rktech-de/PowerMeter-D0/README.md

# PowerMeter-D0
Read PowerMeter D0 (IR) interface with ESP8266 and transmit as MQTT
