rktech-de/PowerMeter-D0/Arduino/README.md

# PowerMeter-D0
Code for Arduino IDE with ESP8266 (WIMO-D1) boards
