rktech-de/PowerMeter-D0/KiCad/Energiezähler-BOM.md

# Energiezähler.kicad_sch BOM

Mo 14 Nov 2022 20:32:45 CET

Generated from schematic by Eeschema 6.0.9-8da3e8f707~116~ubuntu20.04.1

**Component Count:** 31

| Refs | Qty | Component | Description |
| ----- | --- | ---- | --- |
| C101, C103, C106 | 3 | 100n | Unpolarized capacitor<br />Capacitor_SMD:C_0805_2012Metric_Pad1.18x1.45mm_HandSolder |
| C102, C104 | 2 | 100u | Polarized capacitor<br />Capacitor_THT:CP_Radial_D6.3mm_P2.50mm |
| C105 | 1 | 47p | Unpolarized capacitor<br />Capacitor_SMD:C_0805_2012Metric_Pad1.18x1.45mm_HandSolder |
| C107 | 1 | 47n | Unpolarized capacitor<br />Capacitor_SMD:C_0805_2012Metric_Pad1.18x1.45mm_HandSolder |
| D101 | 1 | LED red | Light emitting diode<br />LED_THT:LED_D3.0mm |
| D102 | 1 | LED yellow | Light emitting diode<br />LED_THT:LED_D3.0mm |
| J101 | 1 | Power | Generic connector, single row, 01x02, script generated (kicad-library-utils/schlib/autogen/connector/)<br />Connector_PinHeader_2.54mm:PinHeader_1x02_P2.54mm_Vertical |
| J102 | 1 | Sensor | Generic connector, single row, 01x04, script generated (kicad-library-utils/schlib/autogen/connector/)<br />Connector_PinHeader_2.54mm:PinHeader_1x04_P2.54mm_Vertical |
| Q0 | 1 | SFH309 | Phototransistor NPN<br />http://www.osram-os.com/Graphics/XPic2/00101811_0.pdf/SFH%20309,%20SFH%20309%20FA,%20Lead%20(Pb)%20Free%20Product%20-%20RoHS%20Compliant.pdf<br />LED_THT:LED_D3.0mm_Clear |
| R101, R108 | 2 | 100k | Resistor<br />Resistor_SMD:R_0805_2012Metric_Pad1.20x1.40mm_HandSolder |
| R102, R103 | 2 | 330R | Resistor<br />Resistor_SMD:R_0805_2012Metric_Pad1.20x1.40mm_HandSolder |
| R104, R106 | 2 | 12k | Resistor<br />Resistor_SMD:R_0805_2012Metric_Pad1.20x1.40mm_HandSolder |
| R105, R111, R112 | 3 | 10k | Resistor<br />Resistor_SMD:R_0805_2012Metric_Pad1.20x1.40mm_HandSolder |
| R107 | 1 | 220R | Resistor<br />Resistor_SMD:R_0805_2012Metric_Pad1.20x1.40mm_HandSolder |
| R109 | 1 | 47k | Resistor<br />Resistor_SMD:R_0805_2012Metric_Pad1.20x1.40mm_HandSolder |
| R110 | 1 | 22k | Resistor<br />Resistor_SMD:R_0805_2012Metric_Pad1.20x1.40mm_HandSolder |
| R113 | 1 | 120R | Resistor<br />Resistor_SMD:R_0805_2012Metric_Pad1.20x1.40mm_HandSolder |
| RV101 | 1 | Varistor | Voltage dependent resistor<br />Diode_THT:D_A-405_P12.70mm_Horizontal |
| RV102 | 1 | 10k | Trim-potentiometer<br />Potentiometer_THT:Potentiometer_Bourns_3266W_Vertical |
| SW101 | 1 | SW_Push | Push button switch, generic, two pins<br />Button_Switch_THT:SW_Tactile_SPST_Angled_PTS645Vx58-2LFS |
| U101 | 1 | DC/DC | Generic connector, single row, 01x04, script generated (kicad-library-utils/schlib/autogen/connector/)<br />https://www.amazon.de/PEMENOL-Einstellbar-Spannungwandler-Stromversorgung-Wirkungsgrad/dp/B07DP2MDJQ<br />Connector_PinHeader_2.54mm:PinHeader_1x04_P2.54mm_Vertical |
| U102 | 1 | LMV393 | http://www.ti.com/lit/ds/symlink/lmv331.pdf<br />Package_DIP:DIP-8_W7.62mm |
| U103 | 1 | WeMos_D1_mini | https://wiki.wemos.cc/products:d1:d1_mini#documentation<br />ESP8266:wemos-d1-mini-with-pin-header |
