rktech-de/PowerMeter-D0/KiCad/Montage-all.pdf

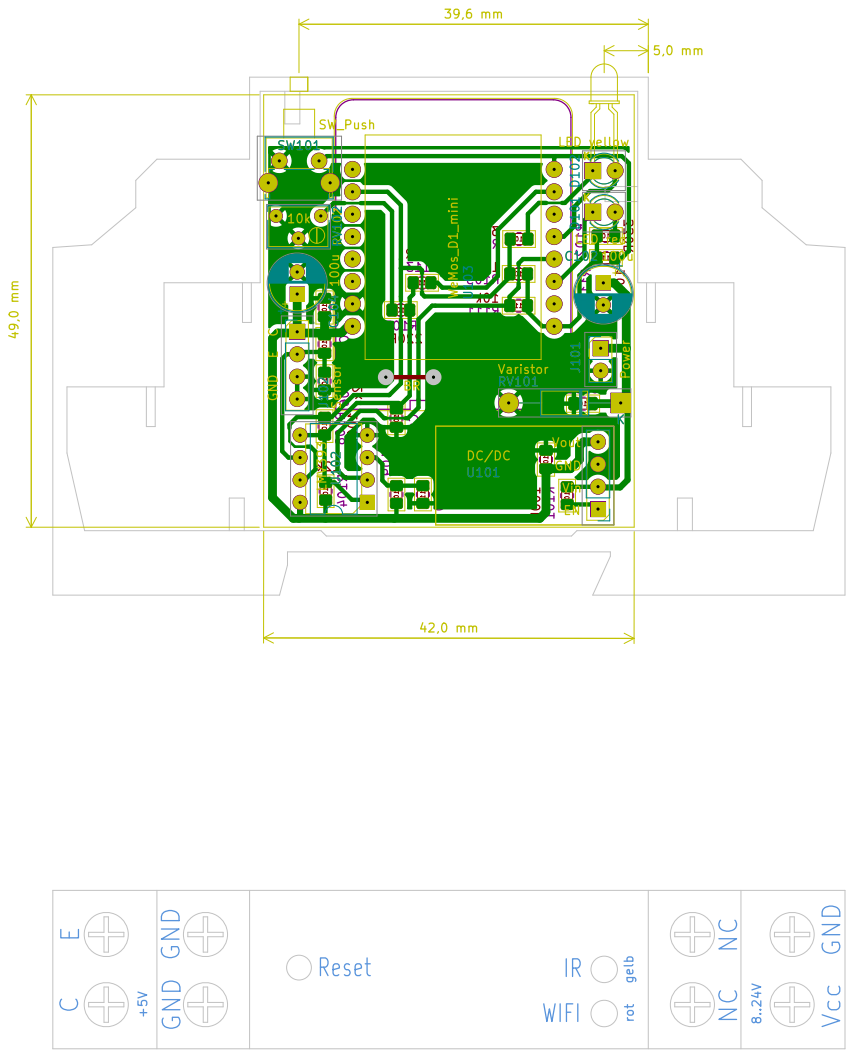
[picture p1: page 1]
