rktech-de/PowerMeter-D0/KiCad/Montage-B.pdf

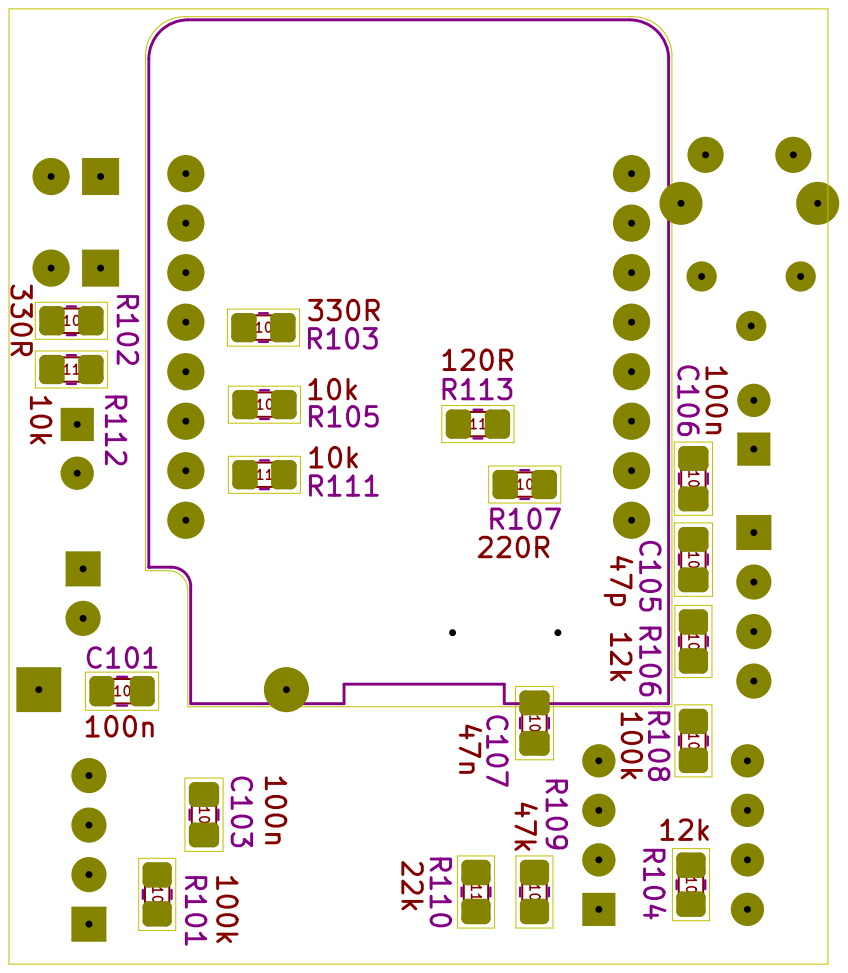
[picture p2: page 1]
