rktech-de/PowerMeter-D0/KiCad/Montage-F.pdf

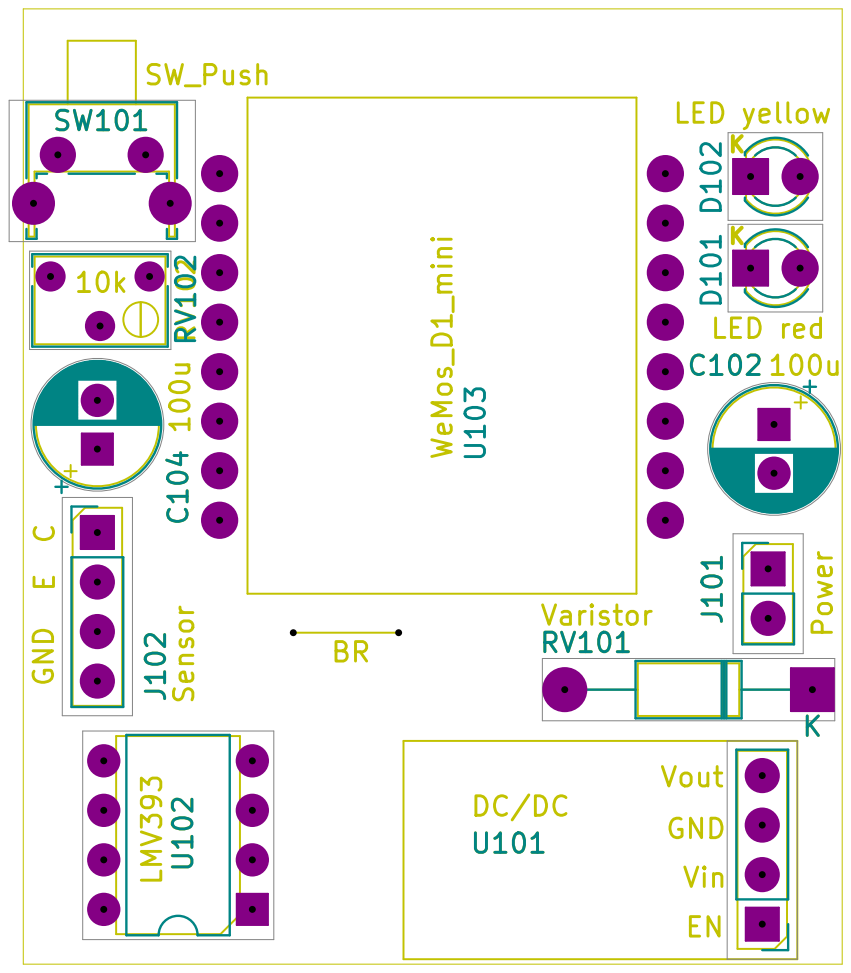
[picture p3: page 1]
