rktech-de/PowerMeter-D0/KiCad/Stromlauf.pdf

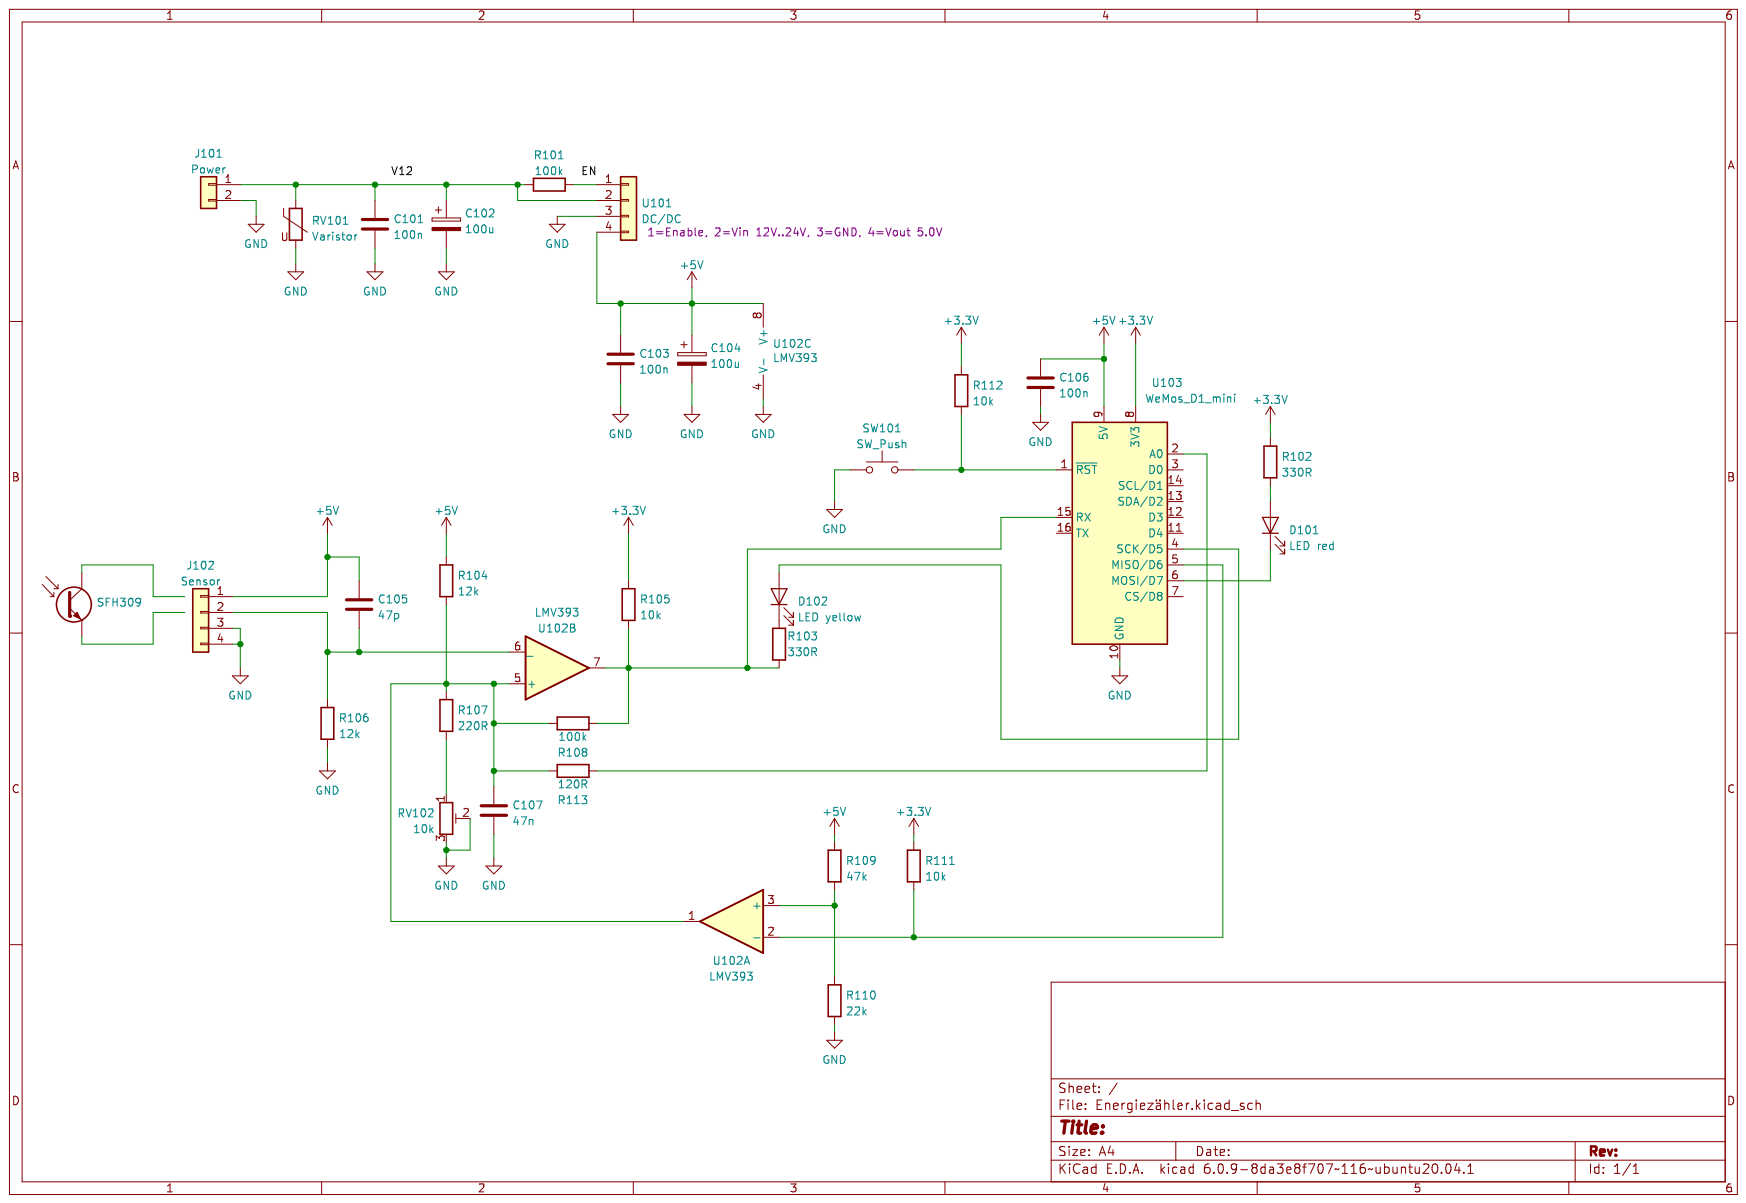
[picture p4: page 1]
