rktech-de/PowerMeter-D0/KiCad/Energiezähler.kicad_pcb

## KiCad design KiCad/Energiezähler.kicad_pcb (2022-11-14)

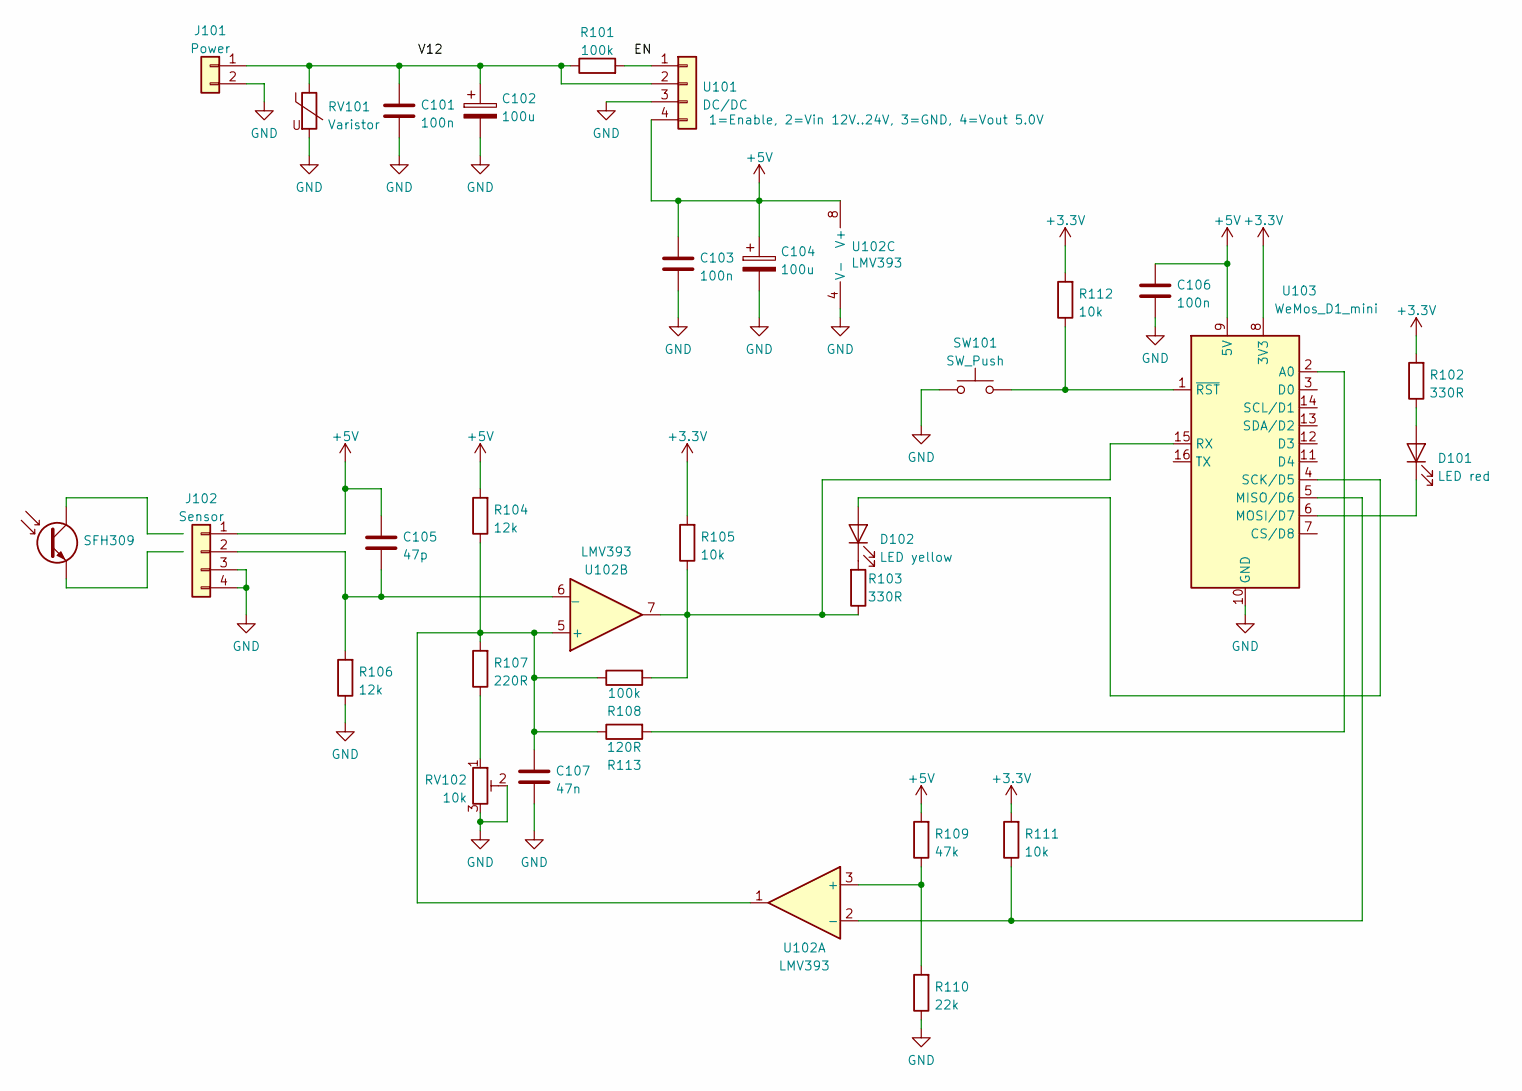
[picture p5: schematic Energiezähler.kicad_sch]

Parts:
C101, C103, C106: 100n; C_0805_2012Metric_Pad1.18x1.45mm_HandSolder
C102, C104: 100u; CP_Radial_D6.3mm_P2.50mm
C105: 47p; C_0805_2012Metric_Pad1.18x1.45mm_HandSolder
C107: 47n; C_0805_2012Metric_Pad1.18x1.45mm_HandSolder
D101: LED red; LED_D3.0mm
D102: LED yellow; LED_D3.0mm
J101: Power; PinHeader_1x02_P2.54mm_Vertical
J102: Sensor; PinHeader_1x04_P2.54mm_Vertical
Q0: SFH309
R101, R108: 100k; R_0805_2012Metric_Pad1.20x1.40mm_HandSolder
R102, R103: 330R; R_0805_2012Metric_Pad1.20x1.40mm_HandSolder
R104, R106: 12k; R_0805_2012Metric_Pad1.20x1.40mm_HandSolder
R105, R111, R112: 10k; R_0805_2012Metric_Pad1.20x1.40mm_HandSolder
R107: 220R; R_0805_2012Metric_Pad1.20x1.40mm_HandSolder
R109: 47k; R_0805_2012Metric_Pad1.20x1.40mm_HandSolder
R110: 22k; R_0805_2012Metric_Pad1.20x1.40mm_HandSolder
R113: 120R; R_0805_2012Metric_Pad1.20x1.40mm_HandSolder
RV101: Varistor; D_A-405_P12.70mm_Horizontal
RV102: 10k; Potentiometer_Bourns_3266W_Vertical
SW101: SW_Push; SW_Tactile_SPST_Angled_PTS645Vx58-2LFS
U101: DC/DC; PinHeader_1x04_P2.54mm_Vertical
U102: LMV393; DIP-8_W7.62mm
U103: WeMos_D1_mini; wemos-d1-mini-with-pin-header

Connections:
+3V3: R102.2, R105.2, R111.2, R112.2, U103.8 (3V3)
+5V: C103.1, C104.1, C105.1, C106.1, J102.1, R104.2, R109.2, U101.4, U102.8 (V+), U103.9 (5V)
GND: C101.2, C102.2, C103.2, C104.2, C106.2, C107.2, J101.2, J102.3, J102.4, R106.1, R110.1, RV101.2, RV102.2, RV102.3, SW101.1, U101.3, U102.4 (V-), U103.10 (GND)
unnamed: C101.1, C102.1, J101.1, R101.1, RV101.1, U101.2
unnamed: C105.2, J102.2, R106.2, U102.6 (_)
unnamed: C107.1, R104.1, R107.2, R108.1, R113.1, U102.1, U102.5 (+)
unnamed: D101.1 (K), U103.6 (MOSI/D7)
unnamed: D101.2 (A), R102.1
unnamed: D102.1 (K), R103.2
unnamed: D102.2 (A), U103.4 (SCK/D5)
unnamed: R101.2, U101.1
unnamed: R103.1, R105.1, R108.2, U102.7, U103.15 (RX)
unnamed: R107.1, RV102.1
unnamed: R109.1, R110.2, U102.3 (+)
unnamed: R111.1, U102.2 (-), U103.5 (MISO/D6)
unnamed: R112.1, SW101.2, U103.1 (~RST)
unnamed: R113.2, U103.2 (A0)

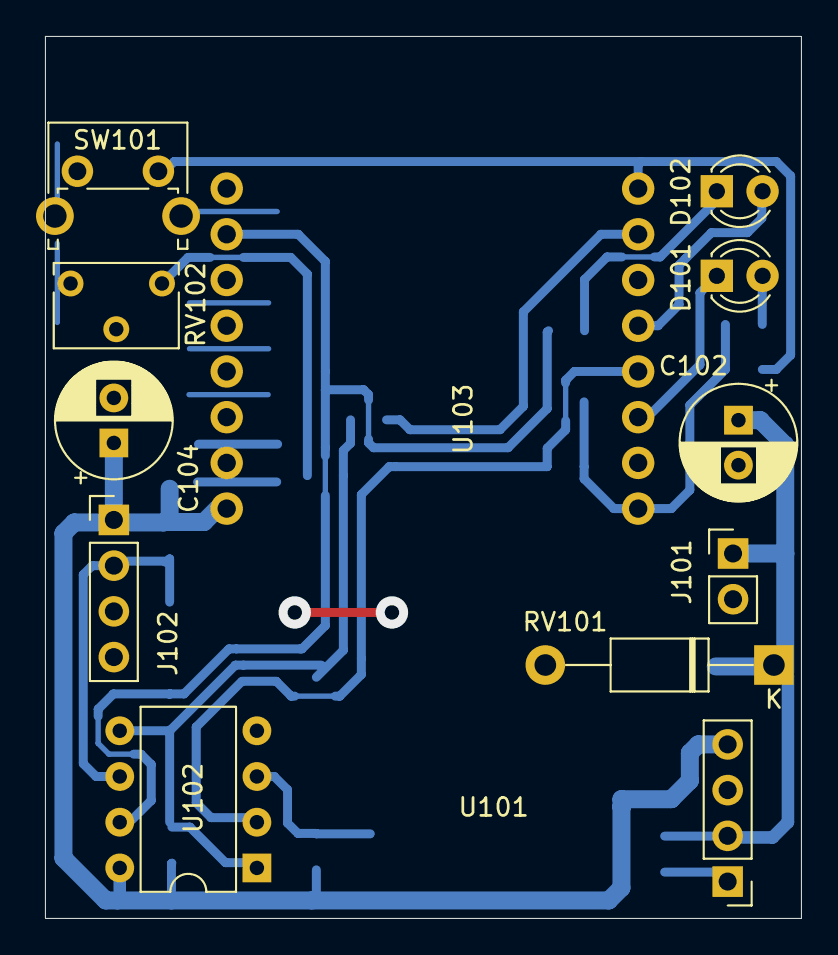
[picture p6: board Energiezähler.kicad_pcb from above]

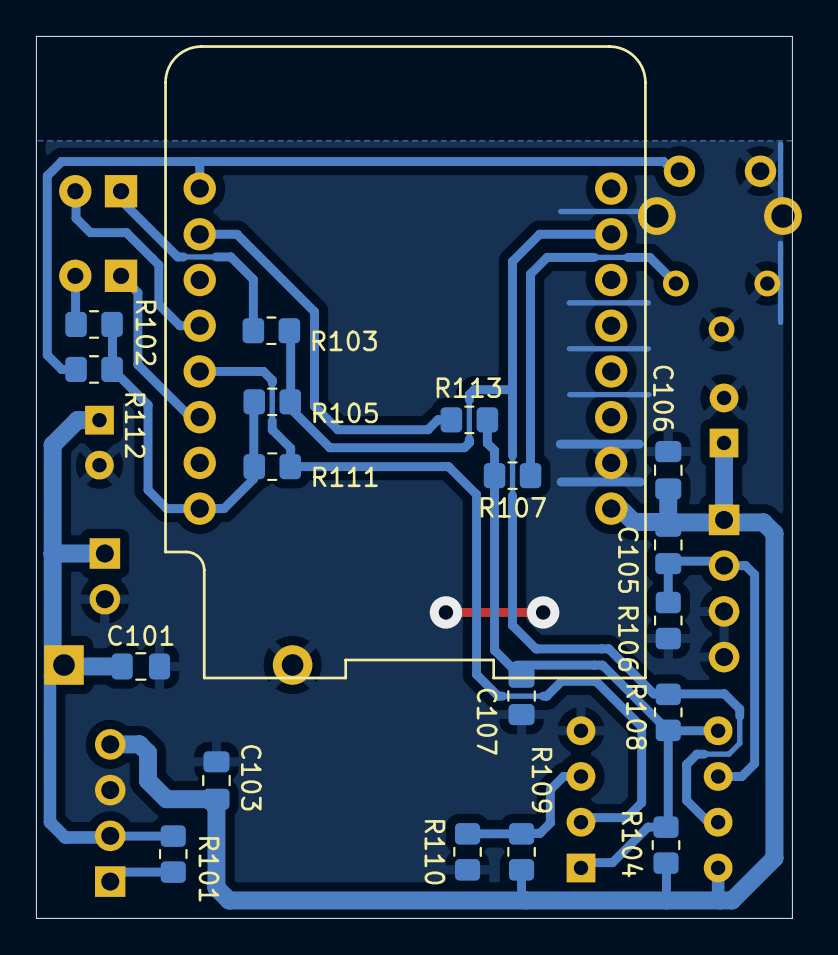
[picture p7: board Energiezähler.kicad_pcb from below]

Board: 2 copper layers, 42.0 x 49.0 mm, 30 parts (19 on the bottom side), 17 nets.
