rktech-de/PowerMeter-D0/(commit log)

2022-11-14 Add hardware data
    [Energiezähler.kicad_pcb, Energiezähler.kicad_sch]
2022-11-14 new hardware data
    [Energiezähler.csv, Energiezähler.kicad_pcb, Energiezähler.kicad_sch]
